Mehdi-Ldj/usb-can-rs485-dongle/docs/renders/board-3d-top.png

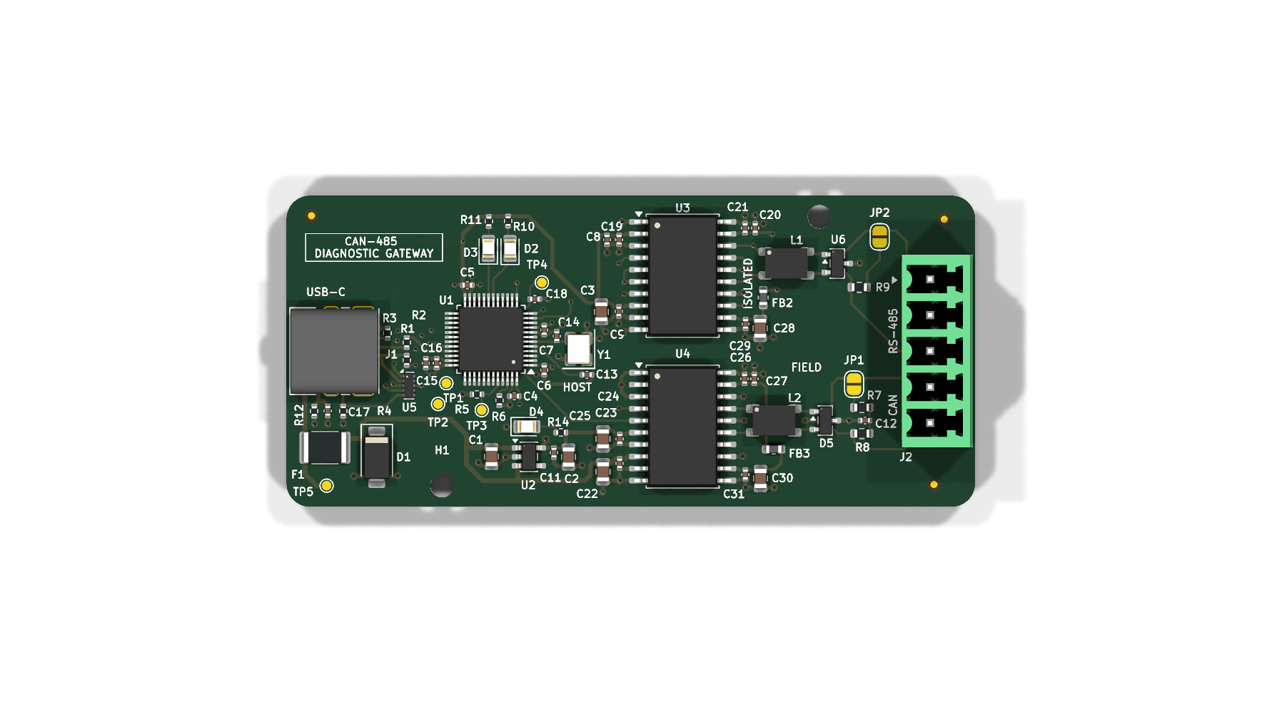
docs/renders/board-3d-top.png
