Mehdi-Ldj/usb-can-rs485-dongle/hardware/rev-a/CAN485-dongle-jlcpcb-bom.csv

Comment | Designator | Footprint | LCSC Part # | MPN | Manufacturer
4u7 | C1,C2 | Capacitor_SMD:C_0805_2012Metric | C1779 | CL21A475KAQNNNE | Samsung
100n | C4,C5,C6,C7,C8,C9,C11,C16,C18,C20,C23,C24,C26,C29,C31 | Capacitor_SMD:C_0402_1005Metric | C1525 | CL05B104KO5NNNC | Samsung
4n7 | C12,C17 | Capacitor_SMD:C_0402_1005Metric | C1538 | 0402B472K500NT | FH
30p | C13,C14 | Capacitor_SMD:C_0402_1005Metric | C107004 | CC0402JRNPO9BN300 | YAGEO
1u | C15 | Capacitor_SMD:C_0402_1005Metric | C52923 | CL05A105KA5NQNC | Samsung
10n | C19,C21,C27 | Capacitor_SMD:C_0402_1005Metric | C15195 | CL05B103KB5NNNC | Samsung
10u | C3,C22,C25,C28,C30 | Capacitor_SMD:C_0805_2012Metric | C15850 | CL21A106KAYNNNE | Samsung
SMAJ5.0A | D1 | Diode_SMD:D_SMA | C83329 | SMAJ5.0A | Littelfuse
Green | D2 | LED_SMD:LED_0805_2012Metric | C98224 | LTST-C171KGKT | Lite-On
Orange | D3 | LED_SMD:LED_0805_2012Metric | C284932 | LTST-C171KFKT | Lite-On
Blue | D4 | LED_SMD:LED_0805_2012Metric | C98225 | LTST-C171TBKT | Lite-On
NUP2105LT1G | D5 | Package_TO_SOT_SMD:SOT-23 | C14486 | NUP2105LT1G | onsemi
0.5A | F1 | CAN485-dongle:Fuse_1812_4532Metric | C17313 | MF-MSMF050-2 | Bourns
BLM18KG601SN1D | FB2,FB3 | Inductor_SMD:L_0603_1608Metric | C85833 | BLM18KG601SN1D | Murata
USB4085-GF-A | J1 | CAN485-dongle:USB_C_Receptacle_GCT_USB4085_Left | C7095263 | USB4085-GF-A | GCT
DB2EVC-3.81-5P-GN | J2 | CAN485-dongle:DB2EVC-3.81-5P | C395701 | DB2EVC-3.81-5P-GN | DORABO
ACT45B-510-2P | L1,L2 | CAN485-dongle:ACT45B-510-2P | C76584 | ACT45B-510-2P-TL003 | TDK
22R | R1,R2 | Resistor_SMD:R_0402_1005Metric | C25092 | 0402WGF220JTCE | UNI-ROYAL
5k1 | R3,R4 | Resistor_SMD:R_0402_1005Metric | C25905 | 0402WGF5101TCE | UNI-ROYAL
10k | R5,R6 | Resistor_SMD:R_0402_1005Metric | C25744 | 0402WGF1002TCE | UNI-ROYAL
60R4 | R7,R8 | Resistor_SMD:R_0603_1608Metric | C403298 | ERJ3EKF60R4V | Panasonic
120R | R9 | Resistor_SMD:R_0603_1608Metric | C22787 | 0603WAF1200T5E | UNI-ROYAL
1k | R10,R11,R14 | Resistor_SMD:R_0402_1005Metric | C11702 | 0402WGF1001TCE | UNI-ROYAL
1M | R12 | Resistor_SMD:R_0402_1005Metric | C26083 | 0402WGF1004TCE | UNI-ROYAL
STM32F072CBT6 | U1 | Package_QFP:LQFP-48_7x7mm_P0.5mm | C81720 | STM32F072CBT6 | STMicroelectronics
TLV75533PDBVR | U2 | Package_TO_SOT_SMD:SOT-23-5 | C404027 | TLV75533PDBVR | Texas Instruments
ADM2582EBRWZ-REEL7 | U3 | Package_SO:SOIC-20W_7.5x12.8mm_P1.27mm | C39494 | ADM2582EBRWZ-REEL7 | Analog Devices
ADM3053BRWZ-REEL7 | U4 | Package_SO:SOIC-20W_7.5x12.8mm_P1.27mm | C117821 | ADM3053BRWZ-REEL7 | Analog Devices
TPD4E05U06DQAR | U5 | Package_SON:USON-10_2.5x1.0mm_P0.5mm | C138714 | TPD4E05U06DQAR | Texas Instruments
SM712.TCT | U6 | Package_TO_SOT_SMD:SOT-23 | C12067 | SM712.TCT | Semtech
8MHz | Y1 | Crystal:Crystal_SMD_3225-4Pin_3.2x2.5mm | C2905353 | XC32M4-8.000-F18LJDT | HCI
