Mehdi-Ldj/usb-can-rs485-dongle/docs/renders/schematic-rev-a.pdf

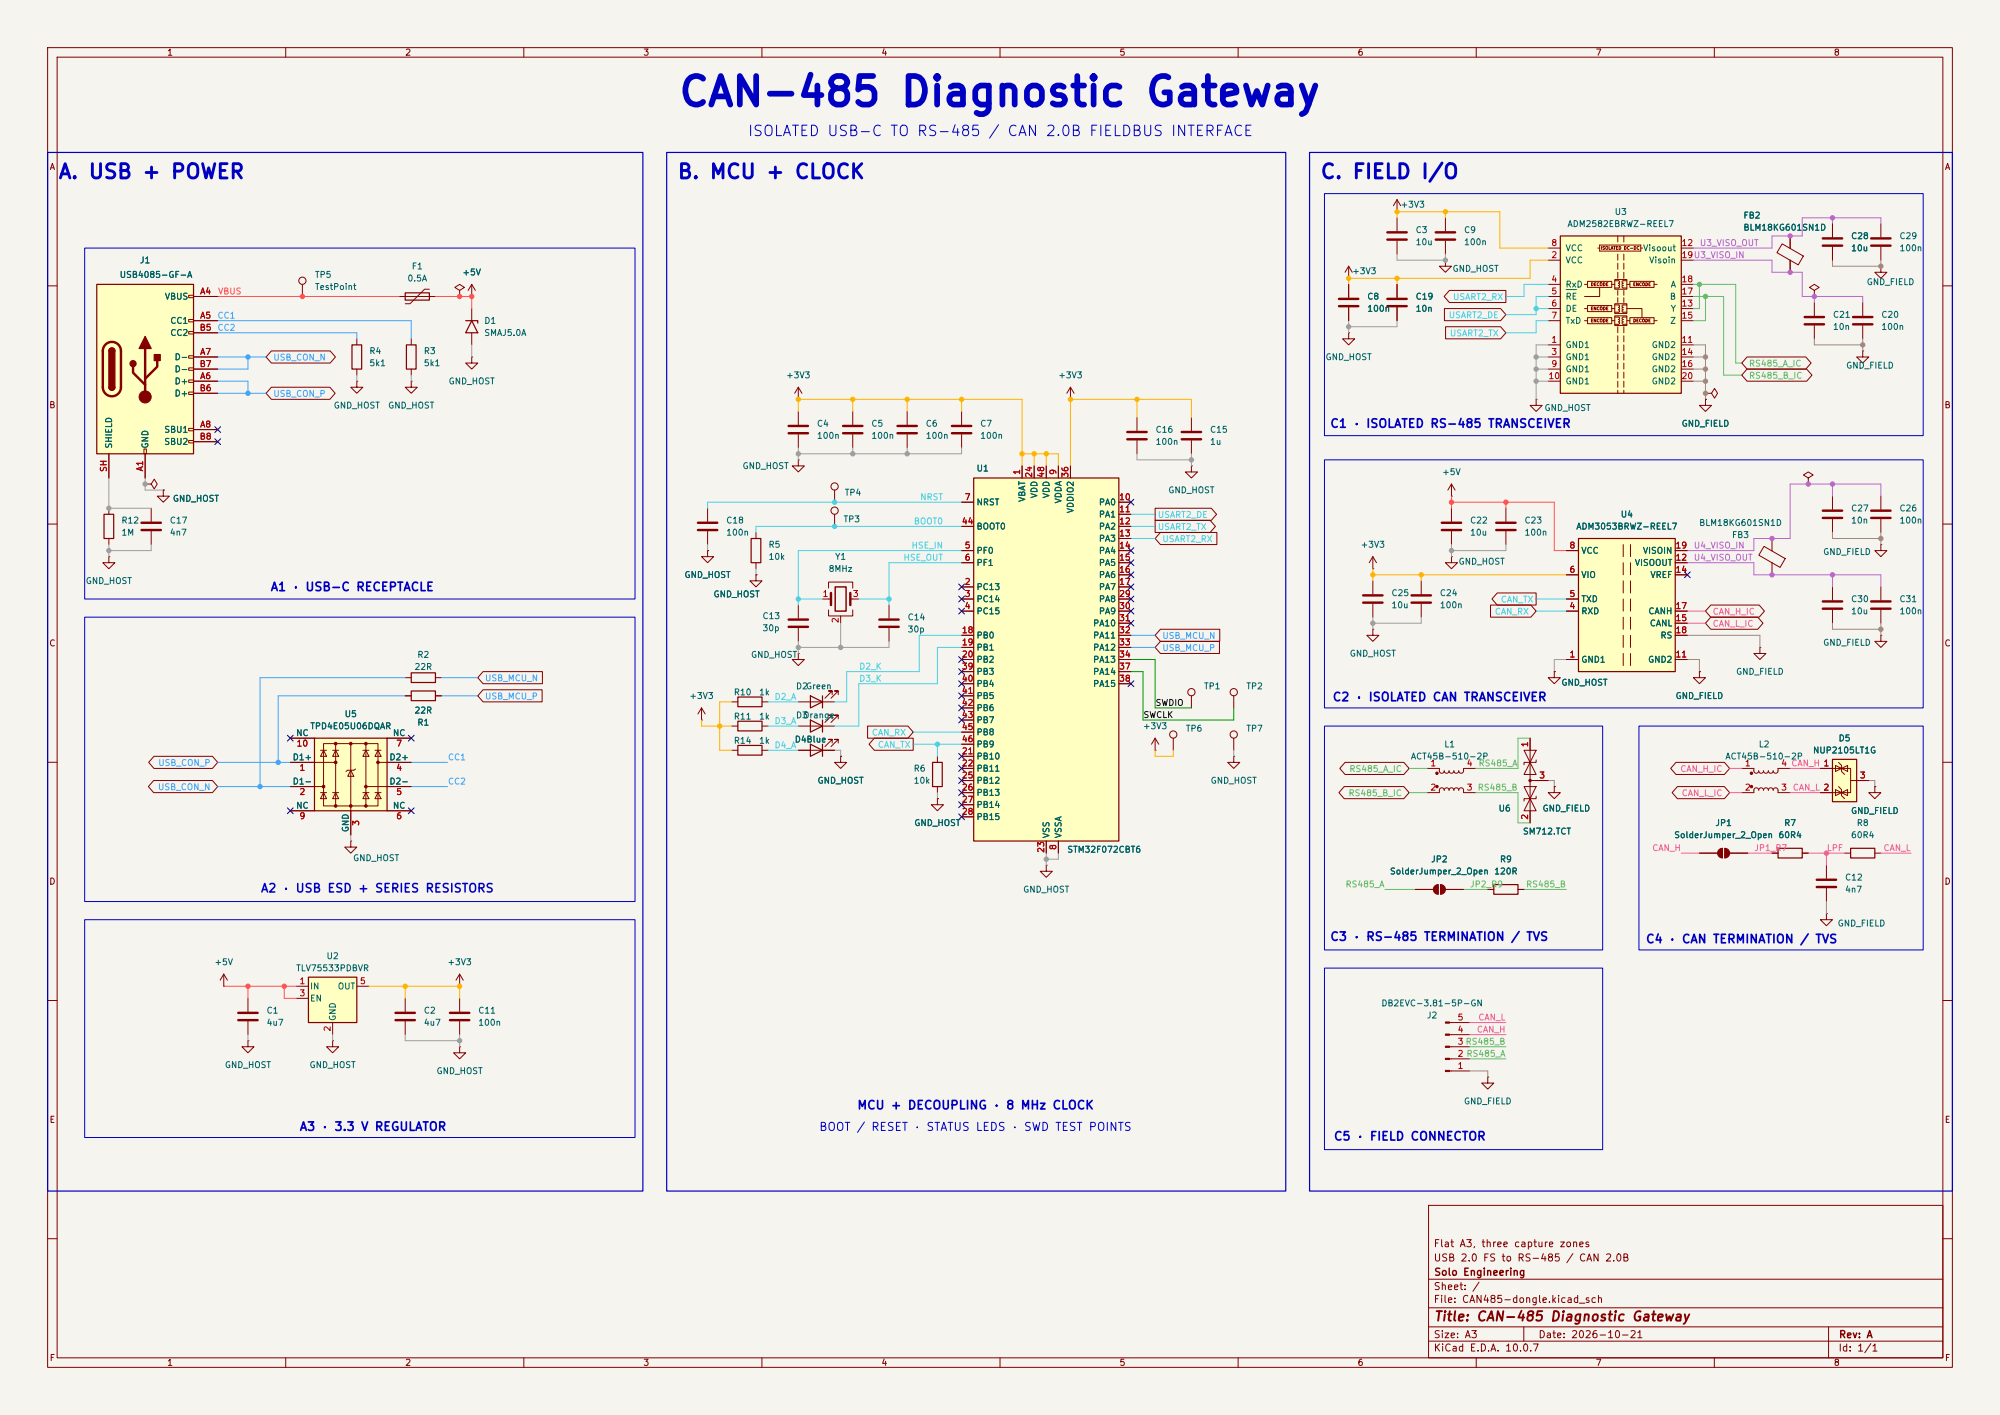
[picture p8: page 1]

ISOLATED USB-C TO RS-485 / CAN 2.0B FIELDBUS INTERFACE

VISOIN 19
VISOOUT 12
VREF 14 CANL 15 CANH 17 RS 18

A2 · USB ESD + SERIES RESISTORS

Flat A3, three capture zones +3V3

MCU + DECOUPLING · 8 MHz CLOCK

BOOT / RESET · STATUS LEDS · SWD TEST POINTS

USB 2.0 FS to RS-485 / CAN 2.0B
Solo Engineering
Sheet: /
File: CAN485-dongle.kicad_sch
Title: CAN-485 Diagnostic Gateway

Size: A3 | Rev: A | F Date: 2026-10-21
KiCad E.D.A. 10.0.7 | Id: 1/1
