Mehdi-Ldj/usb-can-rs485-dongle/hardware/rev-a/CAN485-dongle.kicad_pcb

## KiCad design hardware/rev-a/CAN485-dongle.kicad_pcb (2026-10-28)

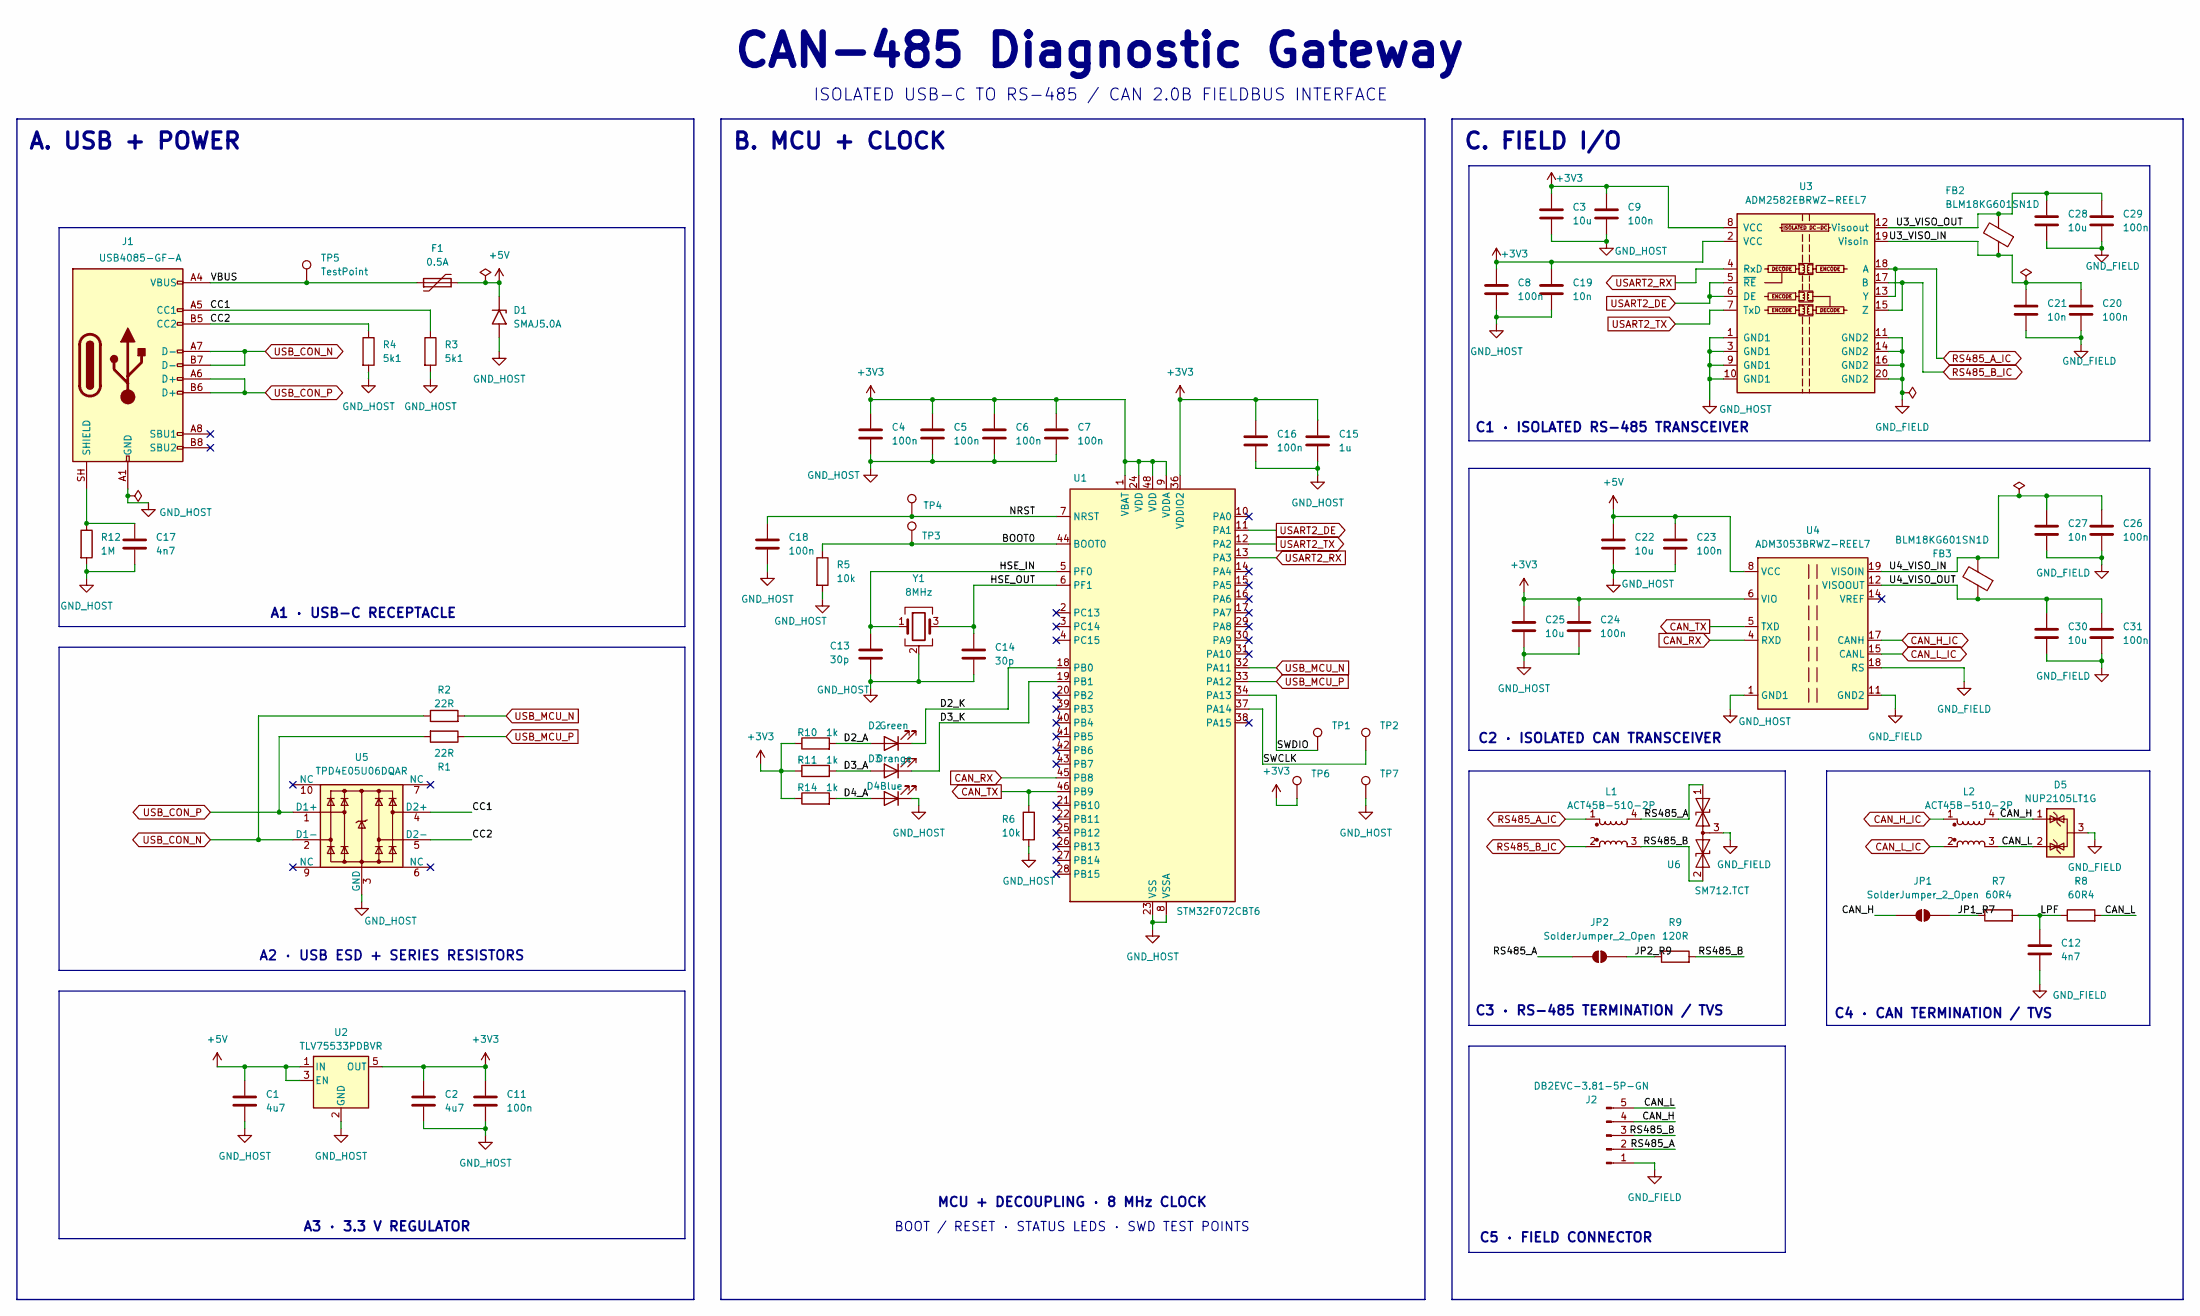
[picture p9: schematic CAN485-dongle.kicad_sch, CAN-485 Diagnostic Gateway]

Parts:
C1, C2: 4u7; C_0805_2012Metric; MPN CL21A475KAQNNNE; LCSC C1779
C3, C22, C25, C28, C30: 10u; C_0805_2012Metric; MPN CL21A106KAYNNNE; LCSC C15850
C4, C5, C6, C7, C8, C9, C11, C16, C18, C20, C23, C24, C26, C29, C31: 100n; C_0402_1005Metric; MPN CL05B104KO5NNNC; LCSC C1525
C12, C17: 4n7; C_0402_1005Metric; MPN 0402B472K500NT; LCSC C1538
C13, C14: 30p; C_0402_1005Metric; MPN CC0402JRNPO9BN300; LCSC C107004
C15: 1u; C_0402_1005Metric; MPN CL05A105KA5NQNC; LCSC C52923
C19, C21, C27: 10n; C_0402_1005Metric; MPN CL05B103KB5NNNC; LCSC C15195
D1: SMAJ5.0A; D_SMA; MPN SMAJ5.0A; LCSC C83329
D2: Green; LED_0805_2012Metric; MPN LTST-C171KGKT; LCSC C98224
D3: Orange; LED_0805_2012Metric; MPN LTST-C171KFKT; LCSC C284932
D4: Blue; LED_0805_2012Metric; MPN LTST-C171TBKT; LCSC C98225
D5: NUP2105LT1G; SOT-23; MPN NUP2105LT1G; LCSC C14486
F1: 0.5A; Fuse_1812_4532Metric; MPN MF-MSMF050-2; LCSC C17313
FB2, FB3: BLM18KG601SN1D; L_0603_1608Metric; MPN BLM18KG601SN1D; LCSC C85833
J1: USB4085-GF-A; USB_C_Receptacle_GCT_USB4085_Left; MPN USB4085-GF-A; LCSC C7095263
J2: DB2EVC-3.81-5P-GN; DB2EVC-3.81-5P; MPN DB2EVC-3.81-5P-GN; LCSC C395701
JP1, JP2: SolderJumper_2_Open; SolderJumper-2_P1.3mm_Open_RoundedPad1.0x1.5mm
L1, L2: ACT45B-510-2P; MPN ACT45B-510-2P-TL003; LCSC C76584
R1, R2: 22R; R_0402_1005Metric; MPN 0402WGF220JTCE; LCSC C25092
R3, R4: 5k1; R_0402_1005Metric; MPN 0402WGF5101TCE; LCSC C25905
R5, R6: 10k; R_0402_1005Metric; MPN 0402WGF1002TCE; LCSC C25744
R7, R8: 60R4; R_0603_1608Metric; MPN ERJ3EKF60R4V; LCSC C403298
R9: 120R; R_0603_1608Metric; MPN 0603WAF1200T5E; LCSC C22787
R10, R11, R14: 1k; R_0402_1005Metric; MPN 0402WGF1001TCE; LCSC C11702
R12: 1M; R_0402_1005Metric; MPN 0402WGF1004TCE; LCSC C26083
TP1, TP2, TP3, TP4, TP5, TP6, TP7: TestPoint; TestPoint_Pad_D1.0mm
U1: STM32F072CBT6; LQFP-48_7x7mm_P0.5mm; MPN STM32F072CBT6; LCSC C81720
U2: TLV75533PDBVR; SOT-23-5; MPN TLV75533PDBVR; LCSC C404027
U3: ADM2582EBRWZ-REEL7; SOIC-20W_7.5x12.8mm_P1.27mm; MPN ADM2582EBRWZ-REEL7; LCSC C39494
U4: ADM3053BRWZ-REEL7; SOIC-20W_7.5x12.8mm_P1.27mm; MPN ADM3053BRWZ-REEL7; LCSC C117821
U5: TPD4E05U06DQAR; USON-10_2.5x1.0mm_P0.5mm; MPN TPD4E05U06DQAR; LCSC C138714
U6: SM712.TCT; SOT-23; MPN SM712.TCT; LCSC C12067
Y1: 8MHz; Crystal_SMD_3225-4Pin_3.2x2.5mm; MPN XC32M4-8.000-F18LJDT; LCSC C2905353

Connections:
+3V3: C2.1, C3.1, C4.1, C5.1, C6.1, C7.1, C8.1, C9.1, C11.1, C15.1, C16.1, C19.1, C24.1, C25.1, R10.1, R11.1, R14.1, TP6.1, U1.1 (VBAT), U1.9 (VDDA), U1.24 (VDD), U1.36 (VDDIO2), U1.48 (VDD), U2.5 (OUT), U3.2 (VCC), U3.8 (VCC), U4.6 (VIO)
+5V: C1.1, C22.1, C23.1, D1.1 (A1), F1.2, U2.1 (IN), U2.3 (EN), U4.8 (VCC)
/BOOT0: R5.1, TP3.1, U1.44 (BOOT0)
/CAN_H: D5.1 (K), J2.4, JP1.1 (A), L2.4
/CAN_L: D5.2 (K), J2.5, L2.3, R8.2
/CC1: J1.A5 (CC1), R3.1, U5.4 (D2+)
/CC2: J1.B5 (CC2), R4.1, U5.5 (D2-)
/D2_A: D2.2 (A), R10.2
/D2_K: D2.1 (K), U1.18 (PB0)
/D3_A: D3.2 (A), R11.2
/D3_K: D3.1 (K), U1.19 (PB1)
/D4_A: D4.2 (A), R14.2
/HSE_IN: C13.1, U1.5 (PF0), Y1.1
/HSE_OUT: C14.1, U1.6 (PF1), Y1.3
/JP1_R7: JP1.2 (B), R7.1
/JP2_R9: JP2.2 (B), R9.1
/LPF: C12.1, R7.2, R8.1
/NRST: C18.1, TP4.1, U1.7 (NRST)
/RS485_A: J2.2, JP2.1 (A), L1.4, U6.1 (A1)
/RS485_B: J2.3, L1.3, R9.2, U6.2 (A2)
/U3_VISO_IN: C20.1, C21.1, FB2.1, U3.19 (Visoin)
/U3_VISO_OUT: C28.1, C29.1, FB2.2, U3.12 (Visoout)
/U4_VISO_IN: C26.1, C27.1, FB3.2, U4.19 (VISOIN)
/U4_VISO_OUT: C30.1, C31.1, FB3.1, U4.12 (VISOOUT)
/VBUS: F1.1, J1.A4 (VBUS), J1.A9 (VBUS), J1.B4 (VBUS), J1.B9 (VBUS), TP5.1
CAN_H_IC: L2.1, U4.17 (CANH)
CAN_L_IC: L2.2, U4.15 (CANL)
CAN_RX: U1.45 (PB8), U4.4 (RXD)
CAN_TX: R6.1, U1.46 (PB9), U4.5 (TXD)
GND_FIELD: C12.2, C20.2, C21.2, C26.2, C27.2, C28.2, C29.2, C30.2, C31.2, D5.3 (A), J2.1, U3.11 (GND2), U3.14 (GND2), U3.16 (GND2), U3.20 (GND2), U4.11 (GND2), U4.13 (GND2), U4.16 (GND2), U4.18 (RS), U4.20 (GND2), U6.3 (common)
GND_HOST: C1.2, C2.2, C3.2, C4.2, C5.2, C6.2, C7.2, C8.2, C9.2, C11.2, C13.2, C14.2, C15.2, C16.2, C17.2, C18.2, C19.2, C22.2, C23.2, C24.2, C25.2, D1.2 (A2), D4.1 (K), J1.A1 (GND), J1.A12 (GND), J1.B1 (GND), J1.B12 (GND), R3.2, R4.2, R5.2, R6.2, R12.2, TP7.1, U1.8 (VSSA), U1.23 (VSS), U1.35 (VSS), U1.47 (VSS), U2.2 (GND), U3.1 (GND1), U3.3 (GND1), U3.9 (GND1), U3.10 (GND1), U4.1 (GND1), U4.3 (GND1), U4.7 (GND1), U4.9 (GND1), U4.10 (GND1), U5.3 (GND), U5.8 (GND), Y1.2 (G), Y1.4 (G)
unnamed: C17.1, J1.SH (SHIELD), R12.1
RS485_A_IC: L1.1, U3.13 (Y), U3.18 (A)
RS485_B_IC: L1.2, U3.15 (Z), U3.17 (B)
USART2_DE: U1.11 (PA1), U3.5 (~RE), U3.6 (DE)
USART2_RX: U1.13 (PA3), U3.4 (RxD)
USART2_TX: U1.12 (PA2), U3.7 (TxD)
USB_CON_N: J1.A7 (D-), J1.B7 (D-), R2.1, U5.2 (D1-)
USB_CON_P: J1.A6 (D+), J1.B6 (D+), R1.2, U5.1 (D1+)
USB_MCU_N: R2.2, U1.32 (PA11)
USB_MCU_P: R1.1, U1.33 (PA12)

Notes on the sheet:
ISOLATED USB-C TO RS-485 / CAN 2.0B FIELDBUS INTERFACE
B. MCU + CLOCK
CAN-485 Diagnostic Gateway
C5 · FIELD CONNECTOR
C1 · ISOLATED RS-485 TRANSCEIVER
C3 · RS-485 TERMINATION / TVS
A3 · 3.3 V REGULATOR
MCU + DECOUPLING · 8 MHz CLOCK
C. FIELD I/O
BOOT / RESET · STATUS LEDS · SWD TEST POINTS
C4 · CAN TERMINATION / TVS
A2 · USB ESD + SERIES RESISTORS
A. USB + POWER
A1 · USB-C RECEPTACLE
C2 · ISOLATED CAN TRANSCEIVER

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
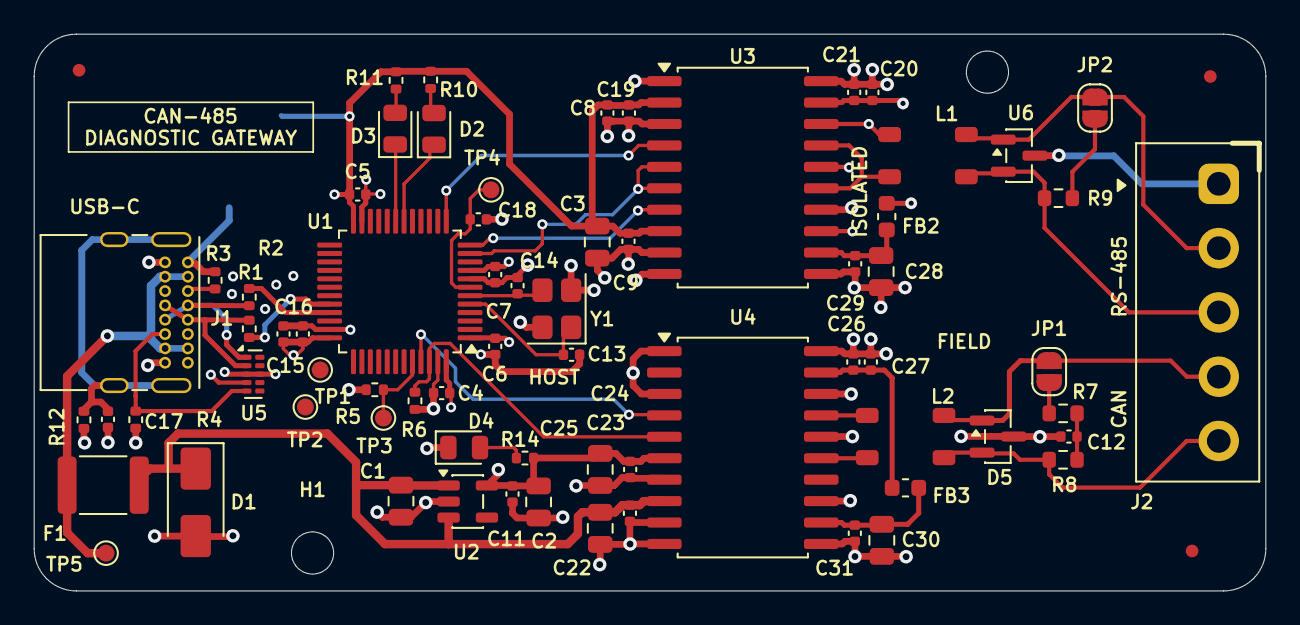
[picture p10: board CAN485-dongle.kicad_pcb from above]

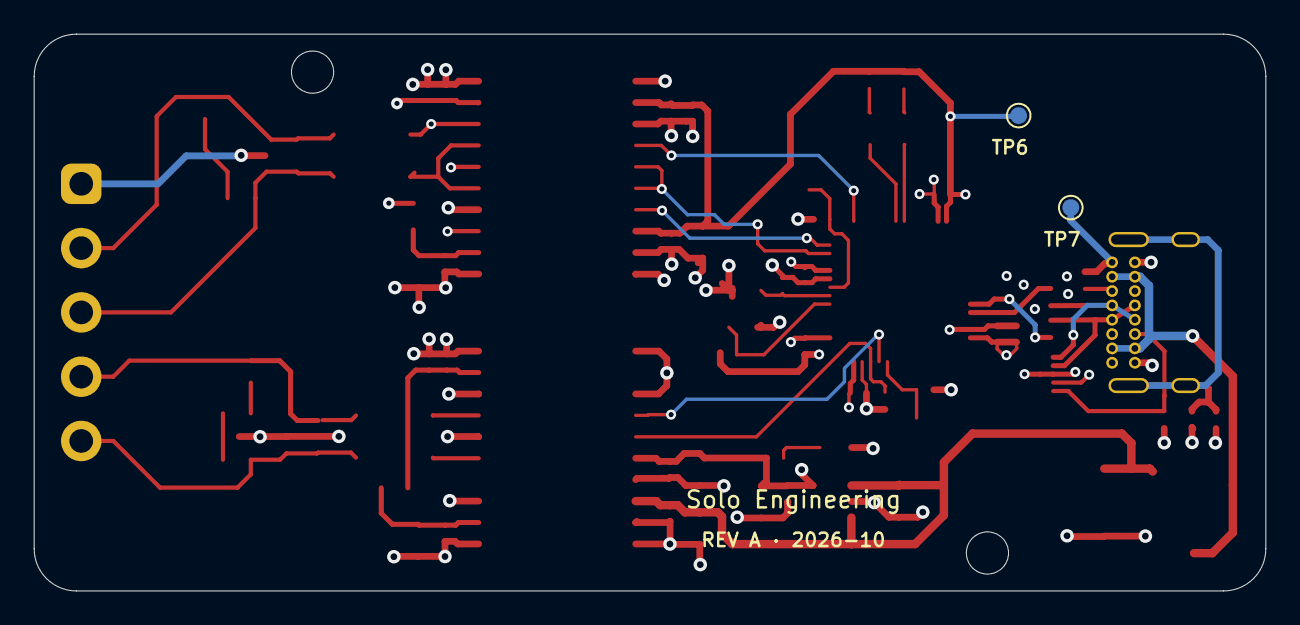
[picture p11: board CAN485-dongle.kicad_pcb from below]

Board: 4 copper layers, 73.0 x 33.0 mm, 76 parts (2 on the bottom side), 41 nets.

Other parts of the board:
FID1, FID2, FID3: Fiducial_0.75mm_Mask1.5mm
H1, H2: MountingHole_2.5mm_Boss5
